LGSInnovations/edison-mini-pcie/README.md

Edison mini PCI-express Block
=============================

This PCB give the Intel Edison the ability to connect to a mini PCI-express card, such as a wifi/cellular network cards, SD/SDHC storage cards, or any other peripheral that connects to the Edison through USB.
