LGSInnovations/edison-mini-pcie/Hardware/mPCIe.brd

## EAGLE design Hardware/mPCIe.brd (2015-07-31)

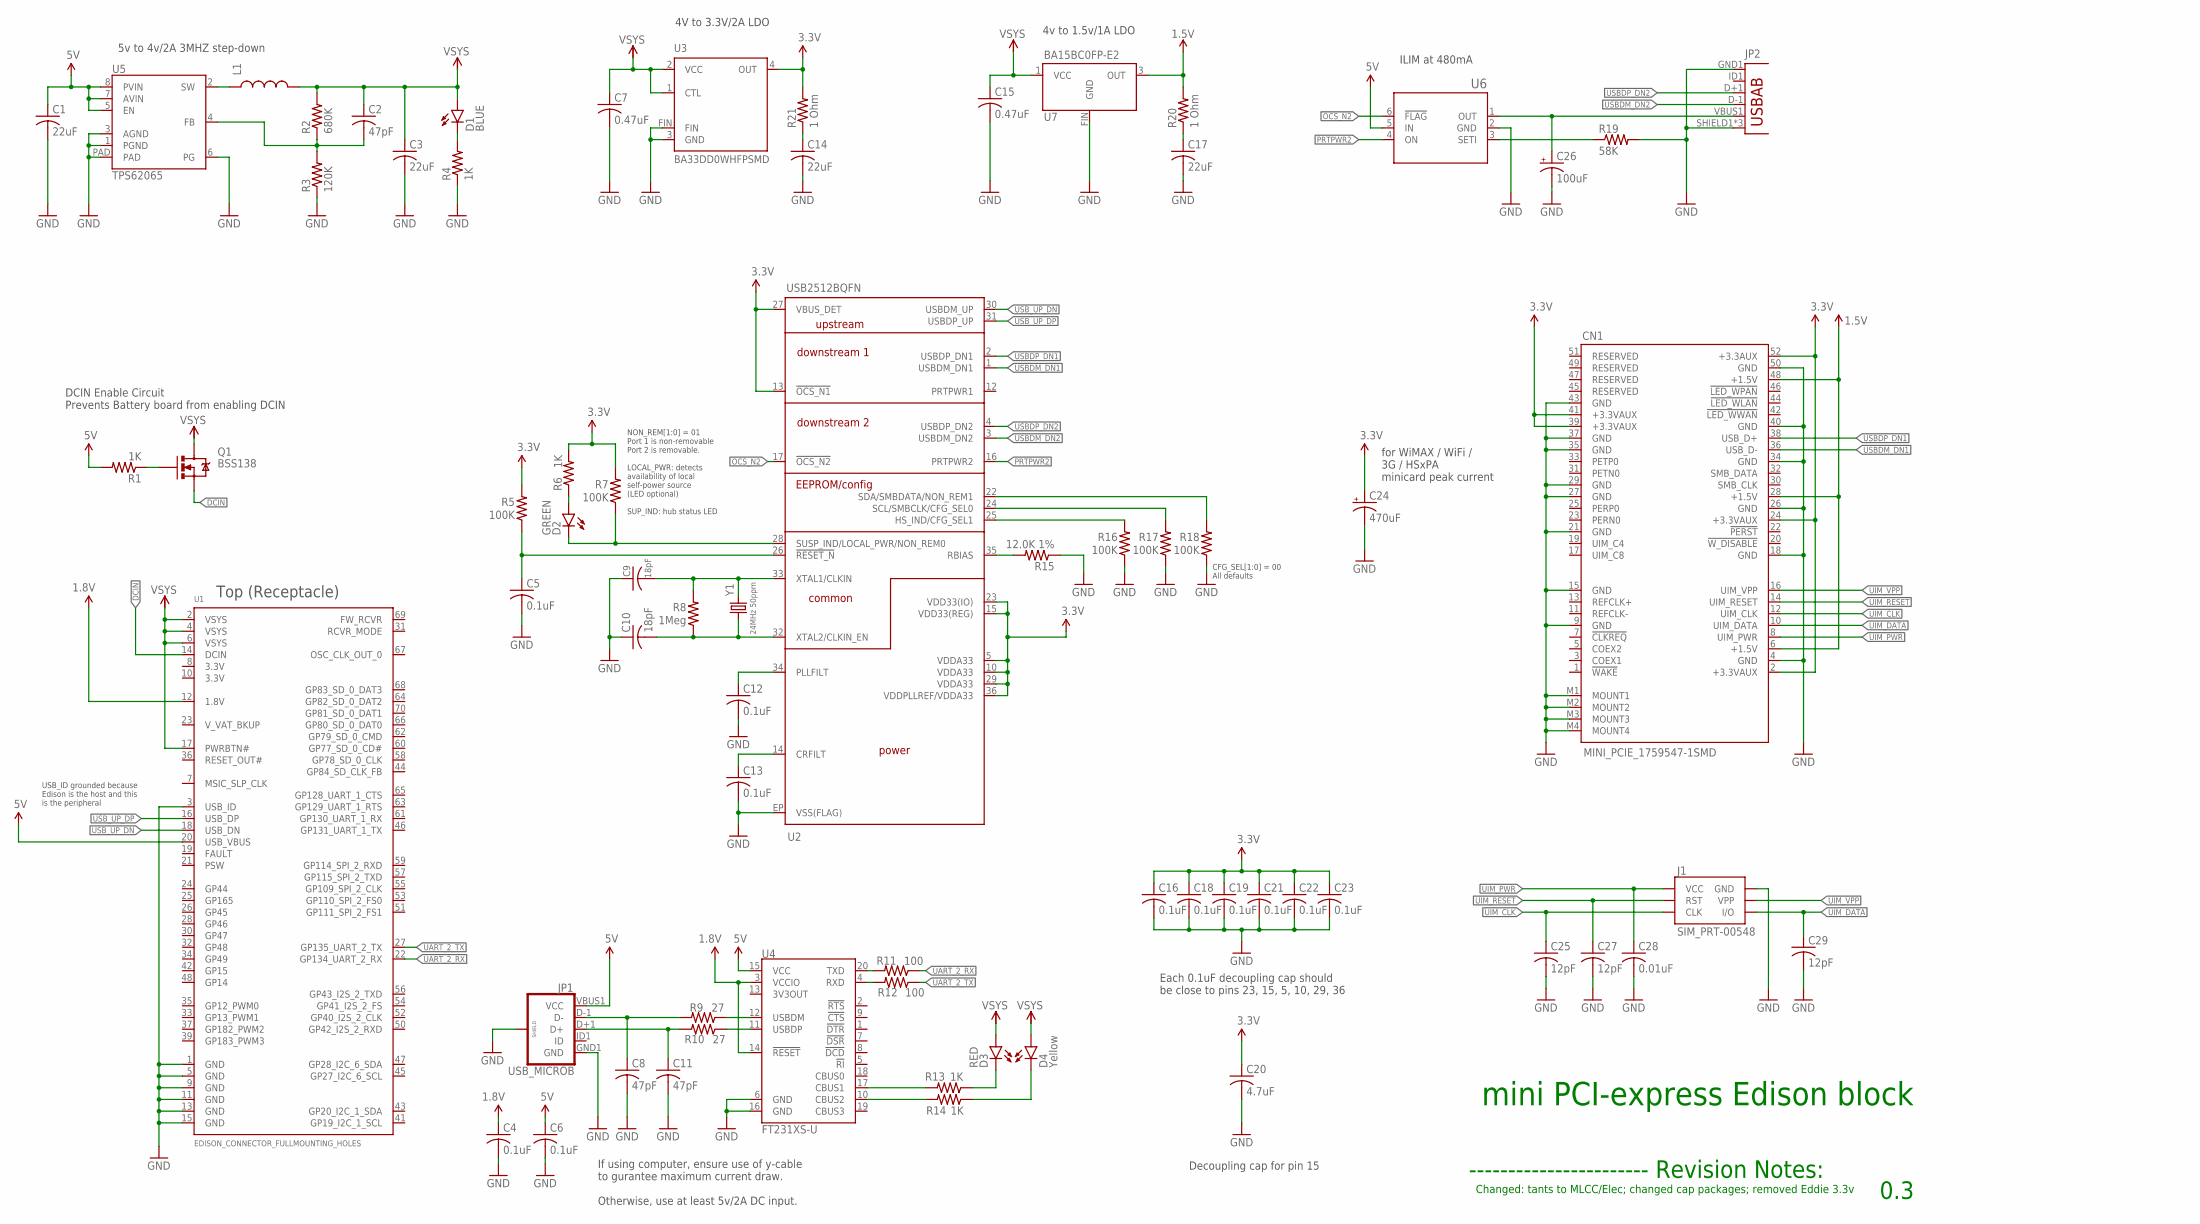
[picture p1: schematic mPCIe.sch]

Parts:
C1, C3, C14, C17: 22uF; C0603K
C2, C8, C11: 47pF; C0402K
C4, C5, C6, C12, C13, C16, C18, C19, C21, C22, C23: 0.1uF; C0402K
C7, C15: 0.47uF; C0402K
C9, C10: 18pF; C0402K
C20: 4.7uF; C0603K
C24: 470uF; PANASONIC_E
C25, C27, C29: 12pF; C0402K
C26: 100uF; PANASONIC_E
C28: 0.01uF; C0402K
CN1: MINI_PCIE_1759547-1SMD; MINI_PCIE_1759547-1
D1: BLUE; LED-0603
D2: GREEN; LED-0603
D3: RED; LED-0603
D4: Yellow; LED-0603
J1: SIM_PRT-00548; SIMHOLDER
JP1: USB_MICROB; USB-B-MICRO-SMD_V03
JP2: USB-ABCONN-11794; USB-AB-MICRO-SMD_V03
L1: INDUCTOR; INDUCTOR-SRP4020
Q1: BSS138; SOT23-3
R1, R4, R6, R13, R14: 1K; R0402
R2: 680K; R0402
R3: 120K; R0402
R5, R7, R16, R17, R18: 100K; R0402
R8: 1Meg; R0402
R9, R10: 27; R0402
R11, R12: 100; R0402
R15: 12.0K 1%; R0402
R19: 58K; R0402
R20, R21: 1 Ohm; R0402
U1: EDISON_CONNECTOR_FULLMOUNTING_HOLES; EDISON_DAUGHTER
U2: USB2512BQFN; QFN-36
U3: BA33DD0WHFPSMD; HRP5
U4: FT231XS-U; SSOP20_L
U5: TPS62065; WSON-8-PAD
U6: MAX4995AAUT+; 21-0058I
U7: BA15BC0FP-E2; TO252-3
Y1: 24MHz 50ppm; CRYSTAL-SMD-5X3

Connections:
1.5V: CN1.6 (+1.5V), CN1.28 (+1.5V), CN1.48 (+1.5V)
1.8V: C4.1, U1.12 (1.8V), U4.3 (VCCIO), U4.14 (!RESET)
3.3V: C16.1, C18.1, C19.1, C20.1, C21.1, C22.1, C23.1, C24.+, CN1.2 (+3.3VAUX), CN1.24 (+3.3VAUX), CN1.39 (+3.3VAUX), CN1.41 (+3.3VAUX), CN1.52 (+3.3AUX), R5.2, R6.2, R7.2, R21.2, U2.5 (VDDA33), U2.10 (VDDA33), U2.13 (!OCS_N1), U2.15 (VDD33(REG)), U2.23 (VDD33(IO)), U2.27 (VBUS_DET), U2.29 (VDDA33), U2.36 (VDDPLLREF/VDDA33), U3.4 (OUT)
5V: C1.1, C6.1, JP1.VBUS1 (VCC), R1.2, U1.20 (USB_VBUS), U4.15 (VCC), U5.5 (EN), U5.7 (AVIN), U5.8 (PVIN), U6.5 (IN)
DCIN: Q1.2 (S), U1.14 (DCIN)
GND: C1.2, C3.2, C4.2, C5.2, C6.2, C7.2, C8.2, C9.1, C10.1, C11.2, C12.2, C13.2, C14.2, C15.2, C16.2, C17.2, C18.2, C19.2, C20.2, C21.2, C22.2, C23.2, C24.-, C25.2, C26.-, C27.2, C28.2, C29.2, CN1.4 (GND), CN1.9 (GND), CN1.15 (GND), CN1.18 (GND), CN1.21 (GND), CN1.26 (GND), CN1.27 (GND), CN1.29 (GND), CN1.34 (GND), CN1.35 (GND), CN1.37 (GND), CN1.40 (GND), CN1.43 (GND), CN1.50 (GND), CN1.M1 (MOUNT1), CN1.M2 (MOUNT2), CN1.M3 (MOUNT3), CN1.M4 (MOUNT4), J1.C5 (GND), JP1.GND1 (GND), JP1.SHIELD1 (SHIELD), JP1.SHIELD2 (SHIELD), JP1.SHIELD3 (SHIELD), JP2.GND1 (GND), JP2.SHIELD1 (SHIELD), JP2.SHIELD2 (SHIELD), JP2.SHIELD3 (SHIELD), R3.1, R4.1, R15.1, R16.1, R17.1, R18.1, R19.2, U1.1 (GND), U1.3 (USB_ID), U1.5 (GND), U1.9 (GND), U1.11 (GND), U1.13 (GND), U1.15 (GND), U2.EP (VSS(FLAG)), U3.3 (GND), U3.FIN, U4.6 (GND), U4.16 (GND), U5.1 (PGND), U5.3 (AGND), U5.6 (PG), U5.PAD, U6.2 (GND), U7.FIN (GND)
unnamed: C13.1, U2.14 (CRFILT)
unnamed: C9.2, R8.2, U2.33 (XTAL1/CLKIN), Y1.3 (2)
unnamed: C12.1, U2.34 (PLLFILT)
unnamed: C10.2, R8.1, U2.32 (XTAL2/CLKIN_EN), Y1.1
unnamed: R15.2, U2.35 (RBIAS)
unnamed: C5.1, R5.1, U2.26 (!RESET_N)
unnamed: D2.C, R7.1, U2.28 (SUSP_IND/LOCAL_PWR/NON_REM0)
unnamed: R18.2, U2.22 (SDA/SMBDATA/NON_REM1)
unnamed: C26.+, JP2.VBUS1 (VBUS), U6.1 (OUT)
unnamed: R16.2, U2.25 (HS_IND/CFG_SEL1)
unnamed: R9.1, U4.12 (USBDM)
unnamed: R17.2, U2.24 (SCL/SMBCLK/CFG_SEL0)
unnamed: R10.1, U4.11 (USBDP)
unnamed: C8.1, JP1.D-1 (D-), R9.2
unnamed: C11.1, JP1.D+1 (D+), R10.2
unnamed: C17.1, R20.1
unnamed: R11.2, U4.20 (TXD)
unnamed: R12.2, U4.4 (RXD)
unnamed: R14.2, U4.10 (CBUS2)
unnamed: R13.2, U4.17 (CBUS1)
unnamed: C14.1, R21.1
unnamed: D3.C, R13.1
unnamed: D4.C, R14.1
unnamed: Q1.1 (G), R1.1
unnamed: L1.P$1 (1), U5.2 (SW)
unnamed: C2.2, R2.1, R3.2, U5.4 (FB)
unnamed: R19.1, U6.3 (SETI)
unnamed: D2.A, R6.1
unnamed: D1.C, R4.2
OCS_N2: U2.17 (!OCS_N2), U6.6 (!FLAG)
P$1: R20.2, U7.3 (OUT)
PRTPWR2: U2.16 (PRTPWR2), U6.4 (ON)
UART_2_RX: R11.1, U1.22 (GP134_UART_2_RX)
UART_2_TX: R12.1, U1.27 (GP135_UART_2_TX)
UIM_CLK: C25.1, CN1.12 (UIM_CLK), J1.C3 (CLK)
UIM_DATA: C29.1, CN1.10 (UIM_DATA), J1.C7 (I/O)
UIM_PWR: C28.1, CN1.8 (UIM_PWR), J1.C1 (VCC)
UIM_RESET: C27.1, CN1.14 (UIM_RESET), J1.C2 (RST)
UIM_VPP: CN1.16 (UIM_VPP), J1.C6 (VPP)
USBDM_DN1: CN1.36 (USB_D-), U2.1 (USBDM_DN1)
USBDM_DN2: JP2.D-1 (D-), U2.3 (USBDM_DN2)
USBDP_DN1: CN1.38 (USB_D+), U2.2 (USBDP_DN1)
USBDP_DN2: JP2.D+1 (D+), U2.4 (USBDP_DN2)
USB_UP_DN: U1.18 (USB_DN), U2.30 (USBDM_UP)
USB_UP_DP: U1.16 (USB_DP), U2.31 (USBDP_UP)
VSYS: C2.1, C3.1, C7.1, C15.1, D1.A, D3.A, D4.A, L1.P$2 (2), Q1.3 (D), R2.2, U1.2 (VSYS), U1.4 (VSYS), U1.6 (VSYS), U1.17 (PWRBTN#), U3.1 (CTL), U3.2 (VCC), U7.1 (VCC)

Notes on the sheet:
Top (Receptacle)
NON_REM[1:0] = 01 Port 1 is non-removable Port 2 is removable. LOCAL_PWR: detects availability of local self-power source (LED optional) SUP_IND: hub status LED
CFG_SEL[1:0] = 00 All defaults
USB_ID grounded because Edison is the host and this is the peripheral
4V to 3.3V/2A LDO
DCIN Enable Circuit Prevents Battery board from enabling DCIN
for WiMAX / WiFi / 3G / HSxPA minicard peak current
If using computer, ensure use of y-cable to gurantee maximum current draw. Otherwise, use at least 5v/2A DC input.
5v to 4v/2A 3MHZ step-down
ILIM at 480mA
4v to 1.5v/1A LDO
mini PCI-express Edison block
0.3
----------------------- Revision Notes:
Changed: tants to MLCC/Elec; changed cap packages; removed Eddie 3.3v
JP2
Each 0.1uF decoupling cap should be close to pins 23, 15, 5, 10, 29, 36
Decoupling cap for pin 15

Board: 4 copper layers, 68 parts (6 on the bottom side), 52 nets, no tracks yet.
