LGSInnovations/edison-mini-pcie/(threads)

Thread 1 (2017-03-15):

Success?

albert21martins, 2017-03-15:
Hello,

I am planning to build the board you design. Before starting, I would like to know if this worked, as I see the eagle board is still unrouted an I do not know if you achieved to make it run.

Sincerely,

Albert

mountainraptor, 2017-03-15:
Hello Albert,

The board worked!  I have a few leftover PCBs around too.  At a minimum I can take a picture of the boards and put them up here for people to see.  Depending on where you are located, I might be able to send you a unpopulated PCB as well.

Adam

mountainraptor, 2017-03-15:
Hello Albert,

We never completed this board.  The Edison-Ethernet was a board that we completed and this design is based on that, but we stopped development on the mini-PCIe board before layout.  Also, I believe this would only route USB to the mini-PCIe slot, to support devices that can be controlled in that manner.

Adam
