LGSInnovations/edison-mini-pcie/(commit log)

2015-07-15 added schematic v0.1
    [mPCIe.sch]
2015-07-17 add revision 0.2 of the schematic; added initial board layout; renumbered components; removed solder jumpers; schematic style considerations
    [mPCIe.brd, mPCIe.sch]
2015-07-21 moved all components onto layout; grouped by major function
    [mPCIe.brd, mPCIe.sch]
2015-07-31 v0.3 of schematic: connected all the 3.3v nets to PSUs and not Edison; removed tantalum caps; replaced LDO Vout caps with MLCCs and series ESRs; laid out board and ready to route
    [mPCIe.brd, mPCIe.sch]
